yibeizzZZ/FoRG-protocol-emulator/(commit log)

2026-10-01 Repair CMOS5L simulation inputs and power-pin configuration
2026-10-01 Add independent fixed UART baseline with pin-level timing tests
    [tb.v, test_uart.py, uart_baseline.v, uart_tx.v]
2026-10-09 Implement M3 UART TX firmware on the M2 protocol engine
2026-10-09 Add reusable full-duplex SPI firmware on the unchanged M2 engine
